scrime-u-bordeaux/marelle/README.md

# marelle
Laurence Bouckaert &amp; Olivier Moyne project on the hopscotch game
