scrime-u-bordeaux/marelle/schema de principe marelle.jpg

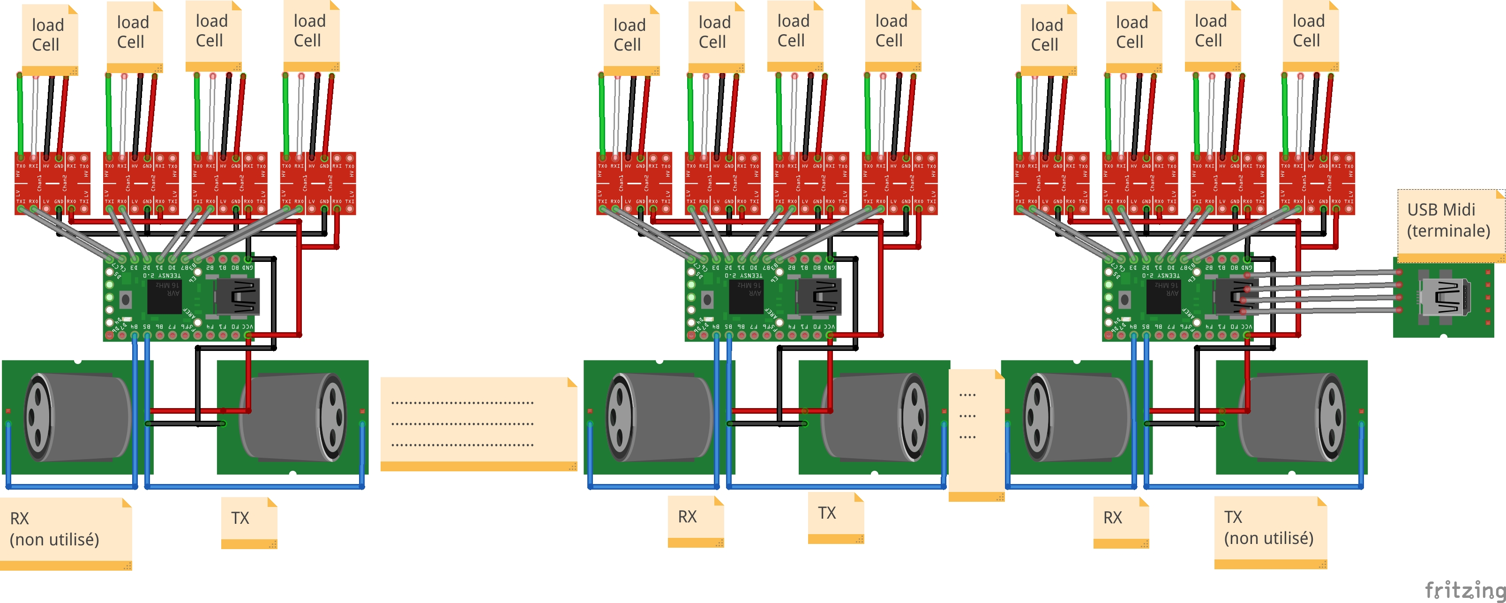
schema de principe marelle.jpg
