scrime-u-bordeaux/marelle/(list of files, drawings)

Other design files:
principe marelle.fzz
